reilleya/RMTS-Hardware/RMTS.kicad_pcb

## KiCad design RMTS.kicad_pcb (2025-01-09)

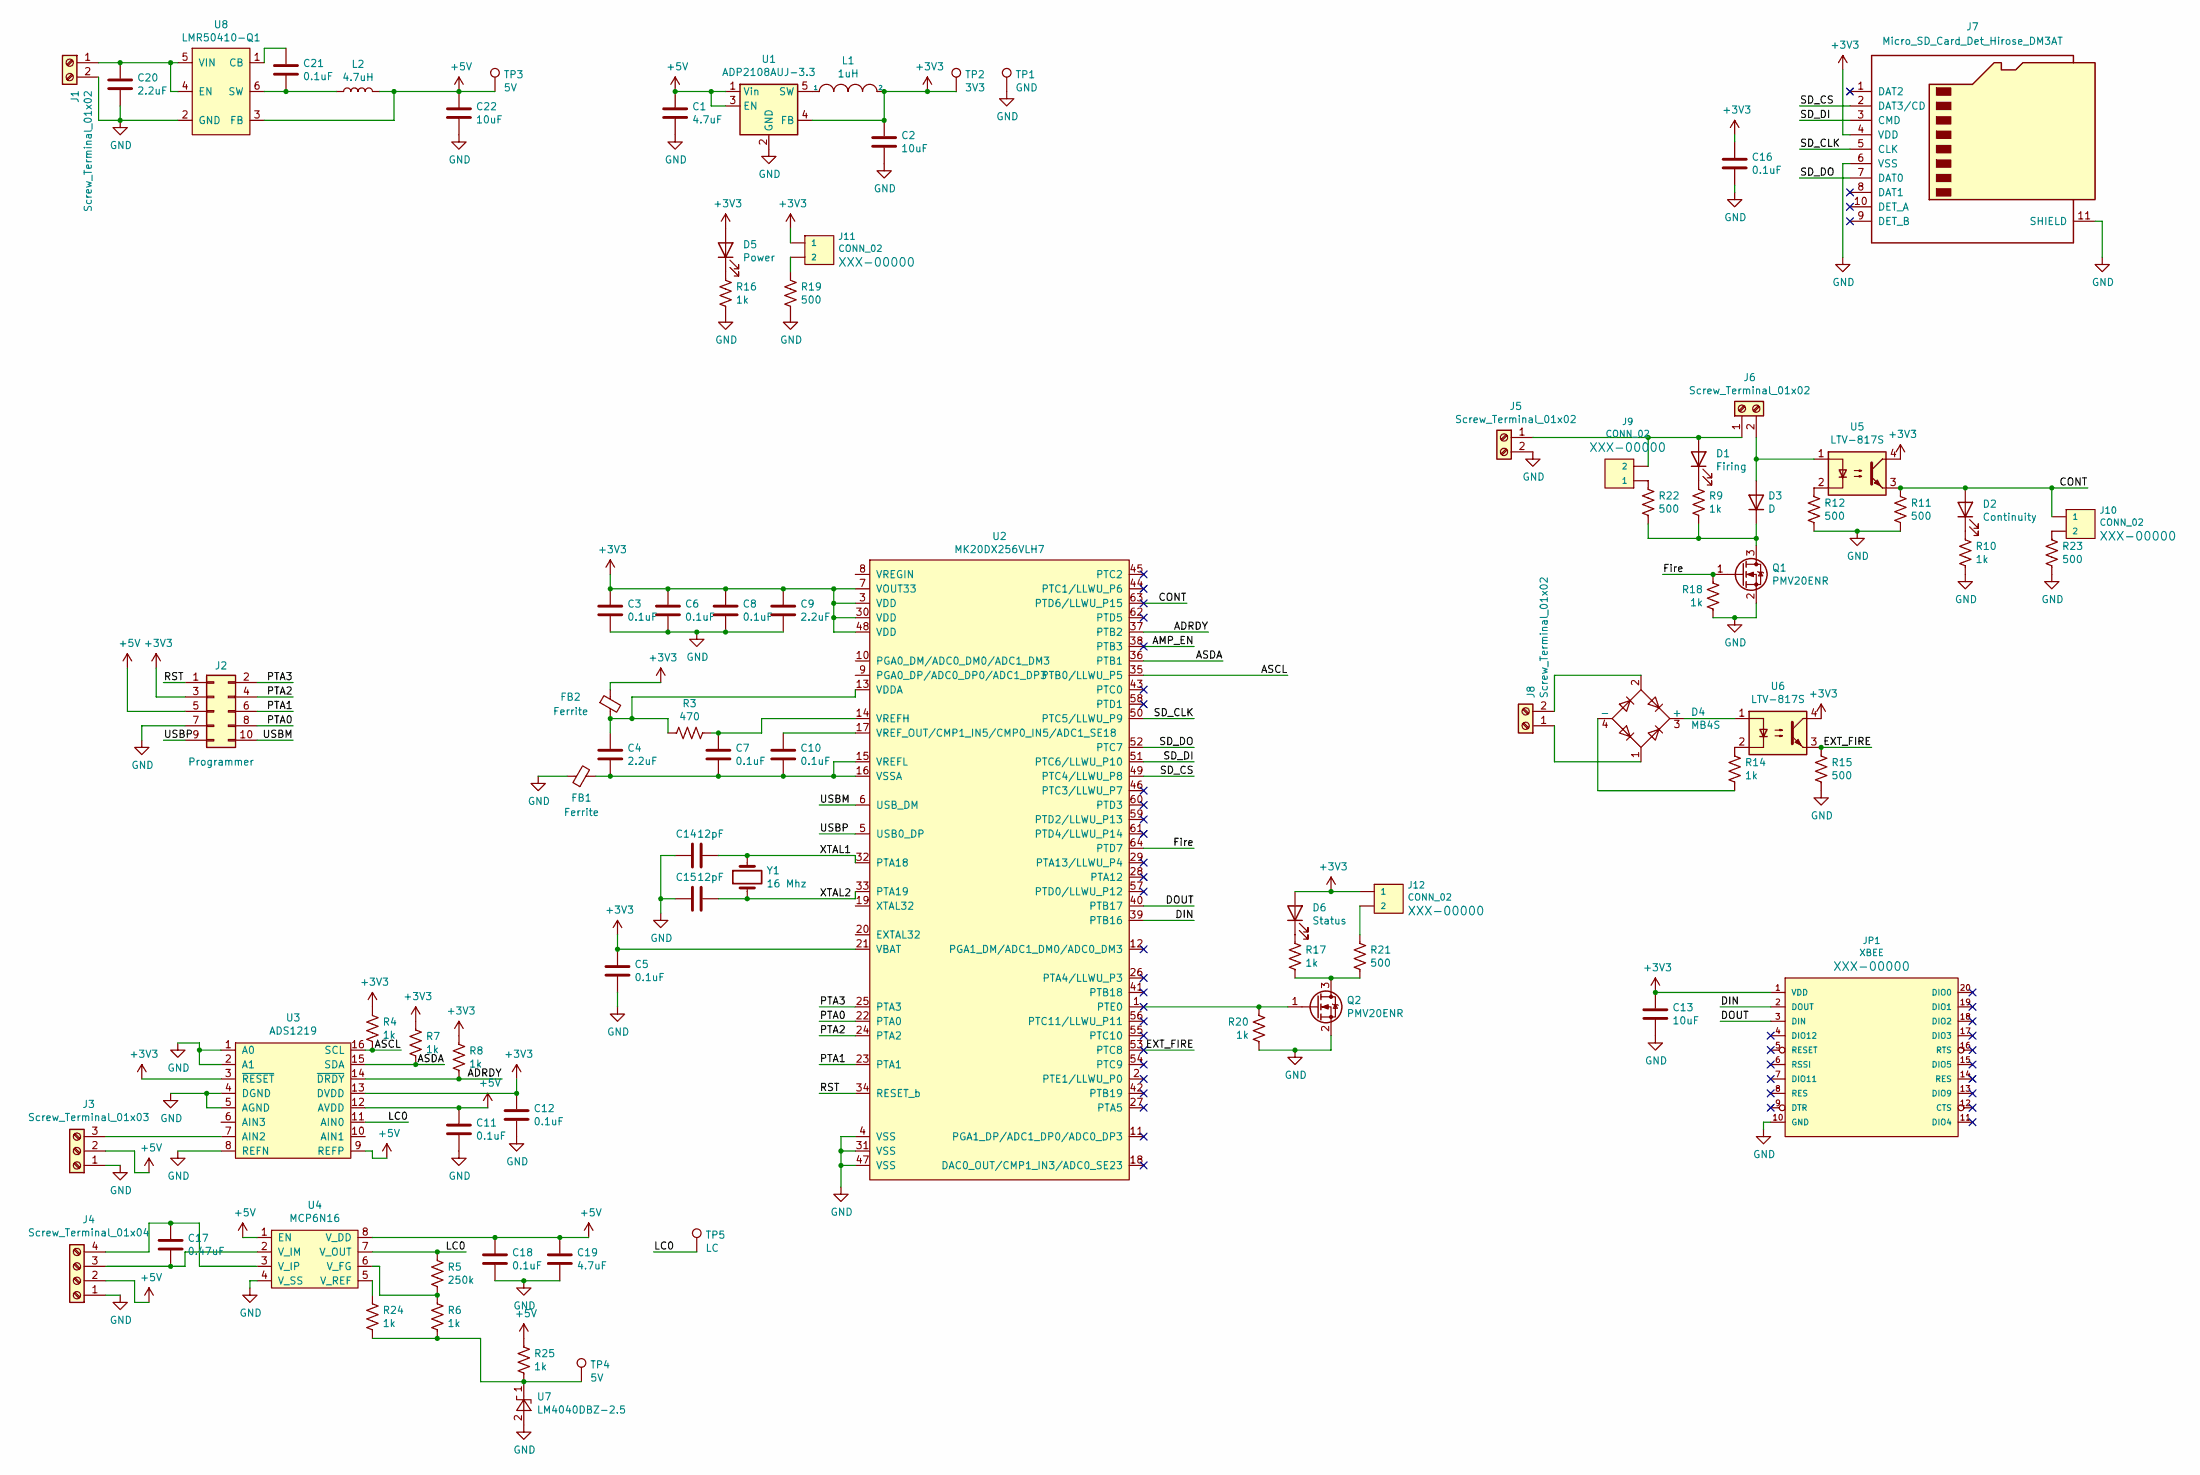
[picture p1: schematic RMTS.kicad_sch]

Parts:
C1, C19: 4.7uF; C_0805_2012Metric_Pad1.15x1.40mm_HandSolder; LCSC C1779
C2: 10uF; CP_Elec_5x3.9; LCSC C340737
C3, C5, C6, C7, C8, C10, C11, C12, C16, C18, C21: 0.1uF; C_0805_2012Metric_Pad1.15x1.40mm_HandSolder; LCSC C49678
C4, C9, C20: 2.2uF; C_0805_2012Metric_Pad1.15x1.40mm_HandSolder; LCSC C125847
C13, C22: 10uF; C_0805_2012Metric_Pad1.15x1.40mm_HandSolder; LCSC C15850
C14, C15: 12pF; C_0805_2012Metric_Pad1.15x1.40mm_HandSolder; LCSC C1792
C17: 0.47uF; C_0805_2012Metric_Pad1.15x1.40mm_HandSolder; LCSC C13967
D1: Firing; LED_0805_2012Metric_Pad1.15x1.40mm_HandSolder; LCSC C84256
D2: Continuity; LED_0805_2012Metric_Pad1.15x1.40mm_HandSolder; LCSC C84256
D3: D; D_SOD-128; LCSC C552950
D4: MB4S; TO-269AA; LCSC C151727
D5: Power; LED_0805_2012Metric_Pad1.15x1.40mm_HandSolder; LCSC C84256
D6: Status; LED_0805_2012Metric_Pad1.15x1.40mm_HandSolder; LCSC C84256
FB1, FB2: Ferrite; C_0805_2012Metric_Pad1.15x1.40mm_HandSolder; LCSC C97001
J1, J5, J6, J8: Screw_Terminal_01x02; SCREWTERMINAL-3.5MM-2
J2: Programmer; PinHeader_2x05_P2.00mm_Vertical
J3: Screw_Terminal_01x03; SCREWTERMINAL-3.5MM-3
J4: Screw_Terminal_01x04; SCREWTERMINAL-3.5MM-4
J7: Micro_SD_Card_Det_Hirose_DM3AT; microSD_HC_Hirose_DM3AT-SF-PEJM5
J9, J10, J11, J12: CONN_02; 1X02
JP1: XBEE
L1: 1uH; L_0805_2012Metric_Pad1.15x1.40mm_HandSolder; LCSC C1042
L2: 4.7uH; L_0805_2012Metric_Pad1.15x1.40mm_HandSolder; LCSC C86090
Q1, Q2: PMV20ENR; SOT-23; LCSC C456088
R3: 470; R_0805_2012Metric_Pad1.15x1.40mm_HandSolder; LCSC C17710
R4, R6, R7, R8, R9, R10, R14, R16, R17, R18, R20, R24, R25: 1k; R_0805_2012Metric_Pad1.15x1.40mm_HandSolder; LCSC C17513
R5: 250k; R_0805_2012Metric_Pad1.15x1.40mm_HandSolder; LCSC C25825
R11, R12, R15, R19, R22, R23: 500; R_0805_2012Metric_Pad1.15x1.40mm_HandSolder; LCSC C17734
R21: 500; R_0805_2012Metric_Pad1.15x1.40mm_HandSolder; LCSC C17513
TP1: GND; TestPoint_THTPad_2.0x2.0mm_Drill1.0mm
TP2: 3V3; TestPoint_THTPad_2.0x2.0mm_Drill1.0mm
TP3, TP4: 5V; TestPoint_THTPad_2.0x2.0mm_Drill1.0mm
TP5: LC; TestPoint_THTPad_2.0x2.0mm_Drill1.0mm
U1: ADP2108AUJ-3.3; TSOT-23-5; LCSC C143875
U2: MK20DX256VLH7; LQFP-64_10x10mm_P0.5mm; LCSC C511780
U3: ADS1219; TSSOP-16_4.4x5mm_P0.65mm; LCSC C2869313
U4: MCP6N16; MSOP-8_3x3mm_P0.65mm; LCSC C636381
U5, U6: LTV-817S; SMDIP-4_W9.53mm; LCSC C189217
U7: LM4040DBZ-2.5; SOT-23; LCSC C468180
U8: LMR50410-Q1; SOT-23-6; LCSC C2871822
Y1: 16 Mhz; HC-49S-SMD-2P-Mini; LCSC C2975359

Connections:
+3V3: C2.1, C3.1, C5.1, C6.1, C8.1, C9.1, C12.1, C13.1, C16.1, D5.2 (A), D6.2 (A), FB2.1, J2.3, J7.4 (VDD), J11.1, J12.1, JP1.1 (VDD), L1.2, R4.1, R7.1, R8.1, TP2.1, U1.4 (FB), U2.3 (VDD), U2.7 (VOUT33), U2.21 (VBAT), U2.30 (VDD), U2.48 (VDD), U3.3 (~RESET), U3.13 (DVDD), U5.4, U6.4
+5V: C1.1, C11.1, C18.1, C19.1, C22.1, J2.5, J3.2, J4.2, L2.2, R25.1, TP3.1, U1.1 (Vin), U1.3 (EN), U3.9 (REFP), U3.12 (AVDD), U4.1 (EN), U4.8 (V_DD), U8.3 (FB)
/ADRDY: R8.2, U2.37 (PTB2), U3.14 (~DRDY)
/AMP_EN: U2.38 (PTB3)
/ASCL: R4.2, U2.35 (PTB0/LLWU_P5), U3.16 (SCL)
/ASDA: R7.2, U2.36 (PTB1), U3.15 (SDA)
/CONT: D2.2 (A), J10.1, R11.1, U2.63 (PTD6/LLWU_P15), U5.3
/DIN: JP1.2 (DOUT), U2.39 (PTB16)
/DOUT: JP1.3 (DIN), U2.40 (PTB17)
/EXT_FIRE: R15.1, U2.53 (PTC8), U6.3
/Fire: Q1.1 (G), R18.1, U2.64 (PTD7)
/LC0: R5.1, TP5.1, U3.11 (AIN0), U4.7 (V_OUT)
/PTA0: J2.8, U2.22 (PTA0)
/PTA1: J2.6, U2.23 (PTA1)
/PTA2: J2.4, U2.24 (PTA2)
/PTA3: J2.2, U2.25 (PTA3)
/RST: J2.1, U2.34 (RESET_b)
/SD_CLK: J7.5 (CLK), U2.50 (PTC5/LLWU_P9)
/SD_CS: J7.2 (DAT3/CD), U2.49 (PTC4/LLWU_P8)
/SD_DI: J7.3 (CMD), U2.51 (PTC6/LLWU_P10)
/SD_DO: J7.7 (DAT0), U2.52 (PTC7)
/USBM: J2.10, U2.6 (USB_DM)
/USBP: J2.9, U2.5 (USB0_DP)
/XTAL1: C14.1, U2.32 (PTA18), Y1.1
/XTAL2: C15.1, U2.33 (PTA19), Y1.2
GND: C1.2, C2.2, C3.2, C5.2, C6.2, C8.2, C9.2, C11.2, C12.2, C13.2, C14.2, C15.2, C16.2, C18.2, C19.2, C20.2, C22.2, FB1.1, J1.2, J2.7, J3.1, J4.1, J5.2, J7.6 (VSS), J7.11 (SHIELD), JP1.10 (GND), Q1.2 (S), Q2.2 (S), R10.2, R11.2, R12.2, R15.2, R16.2, R18.2, R19.2, R20.2, R23.2, TP1.1, U1.2 (GND), U2.4 (VSS), U2.31 (VSS), U2.47 (VSS), U3.1 (A0), U3.2 (A1), U3.4 (DGND), U3.5 (AGND), U3.8 (REFN), U4.4 (V_SS), U7.2 (A), U8.2 (GND)
unnamed: D1.2 (A), J5.1, J6.1, J9.2
unnamed: D1.1 (K), R9.1
unnamed: D2.1 (K), R10.1
unnamed: D3.2 (A), J6.2, U5.1
unnamed: D3.1 (K), Q1.3 (D), R9.2, R22.2
unnamed: D4.3 (+), U6.1
unnamed: D4.4 (-), R14.2
unnamed: D5.1 (K), R16.1
unnamed: D6.1 (K), R17.1
unnamed: C20.1, J1.1, U8.4 (EN), U8.5 (VIN)
unnamed: J3.3, U3.7 (AIN2)
unnamed: C17.2, J4.3, U4.2 (V_IM)
unnamed: C17.1, J4.4, U4.3 (V_IP)
unnamed: D4.1, J8.1
unnamed: D4.2, J8.2
unnamed: J9.1, R22.1
unnamed: J10.2, R23.1
unnamed: J11.2, R19.1
unnamed: J12.2, R21.1
unnamed: Q2.3 (D), R17.2, R21.2
unnamed: R12.1, U5.2
unnamed: R14.1, U6.2
unnamed: L1.1, U1.5 (SW)
unnamed: C4.1, FB2.2, R3.2, U2.13 (VDDA)
unnamed: C7.1, R3.1, U2.14 (VREFH)
unnamed: C4.2, C7.2, C10.2, FB1.2, U2.15 (VREFL), U2.16 (VSSA)
unnamed: C10.1, U2.17 (VREF_OUT/CMP1_IN5/CMP0_IN5/ADC1_SE18)
unnamed: R5.2, R6.1, U4.6 (V_FG)
unnamed: R24.1, U4.5 (V_REF)
unnamed: R6.2, R24.2, R25.2, TP4.1, U7.1 (K)
unnamed: C21.1, U8.1 (CB)
unnamed: C21.2, L2.1, U8.6 (SW)

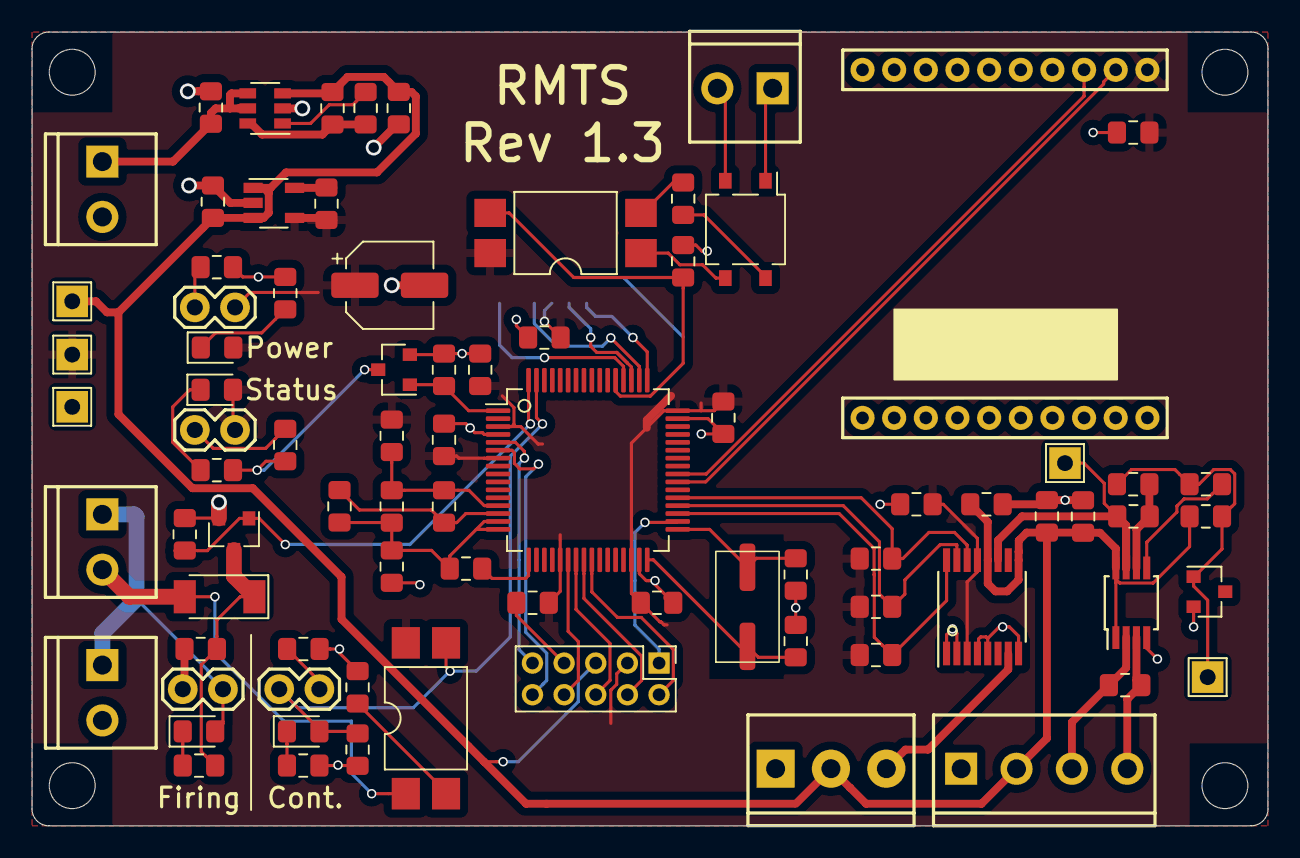
[picture p2: board RMTS.kicad_pcb from above]

Board: 2 copper layers, 78.1 x 50.2 mm, 83 parts (1 on the bottom side), 57 nets.
