reilleya/RMTS-Hardware/(threads)

Thread 2 (2019-12-23):

Test stand data

benrussell11, 2019-12-23:
Hi Andrew,

I was wondering if you can send me a couple of sets of data from your test stand?

My in-flight data logger is working and I'd like to be able to compare your test results with thrust derived from pressure using my spreadsheet.

Best format would be a csv file: Time (sec), pressure (psi), thrust (lbs) and the exit and throat diameters (in) or what whatever units the data were recorded in.

I'll share the results.

Ben

Closed 2020-03-19.

Thread 3 (2020-01-30):

Add resistor to make more batteries recognize board

reilleya, 2020-01-30:
Due to the board's low current draw, some batteries seem to not notice that it is connected and do not give it current. Others will power it but only when transducers are connected. To fix this, add a resistor (maybe 700 ohms like the load cell) between 5v and ground to keep batteries from powering off.

Closed 2020-03-12.

Thread 4 (2020-08-26):

Fix external LED headers

reilleya, 2020-08-26:
The external LED headers have low forward voltage so they don't work with anything other than red LEDs. Change it so they aren't directly in parallel with the onboard LEDs and give them a higher voltage.

Closed 2020-12-15.

Thread 6 (2020-12-22):

Remove USB port

reilleya, 2020-12-22:
Replace it with terminal blocks and a 5V regulator

Closed 2021-01-24.
