reilleya/RMTS-Hardware/(commit log)

2019-07-29 Initial commit with schematic
    [RMTS.kicad_pcb, RMTS.sch]
2019-08-02 Updated schematic, started layout
    [RMTS.kicad_pcb, RMTS.sch]
2019-08-03 Added load capacitors to crystal
    [RMTS.sch]
2019-08-03 Fixed unit notation
    [RMTS.sch]
2019-08-03 Added backup crystal schematic symbol
    [RMTS.sch]
2019-08-03 Updated SD card connector to standard
    [RMTS.sch]
2019-08-03 Removed previous SD card connector
    [RMTS.sch]
2019-08-03 Added no-connect flags
    [RMTS.sch]
2019-08-03 Fixed rescued symbols
    [RMTS.sch]
2019-08-03 Fixed broken header
    [RMTS.sch]
2019-08-03 Fixed older microSD footprint
    [RMTS.sch]
2019-08-10 Finished layout
    [RMTS.kicad_pcb, RMTS.sch]
2019-08-11 Cleaned up silkscreen
    [RMTS.kicad_pcb]
2019-08-11 Added label to screw terminals
    [RMTS.kicad_pcb]
2019-08-11 Added 3v3 top plane
    [RMTS.kicad_pcb]
2019-08-24 Changed USB to full size, connected amp enable, cleaned up routing
    [RMTS.kicad_pcb, RMTS.sch]
2019-08-25 Fixed mistakes
    [RMTS.kicad_pcb, RMTS.sch]
2019-08-25 Added keepout regions near mounting holes
    [RMTS.kicad_pcb]
2019-09-08 Pulled ADC enable high, added diode to firing circuit, rerouted some traces
    [RMTS.kicad_pcb, RMTS.sch]
2019-09-15 Removed backup crystal, resized board
    [RMTS.kicad_pcb, RMTS.sch]
2019-10-07 Added continuity optocoupler, capacitor pads to loadcell connection
    [RMTS.kicad_pcb, RMTS.sch]
2020-02-08 Added resistor to avoid battery shutting off
    [RMTS.kicad_pcb, RMTS.sch]
2020-02-12 Removed USB pyro power jumper
    [RMTS.kicad_pcb, RMTS.sch]
2020-02-25 Updated amplifier to MCP6N16, incremented revision number
    [RMTS.kicad_pcb, RMTS.sch]
2020-03-05 Flipped SD card, added external firing circuit
    [RMTS.kicad_pcb, RMTS.sch]
2020-03-06 Added power LED, moved labels, cleaned up some traces
    [RMTS.kicad_pcb, RMTS.sch]
2020-03-10 Added status LED, hid labels
    [RMTS.kicad_pcb, RMTS.sch]
2020-03-12 Added headers for LEDs, aligned some components better
    [RMTS.kicad_pcb, RMTS.sch]
2020-03-28 Added logo
    [RMTS.kicad_pcb]
2020-03-29 Added silkscreen box for serial number
    [RMTS.kicad_pcb]
2020-04-12 Increased font size of terminal block labels
    [RMTS.kicad_pcb]
2020-04-20 Updated logo to bitmap
    [RMTS.kicad_pcb]
2020-05-23 Add pulldown to firing circuit
    [RMTS.kicad_pcb, RMTS.sch]
2020-06-29 Add LCSC part numbers to components
    [RMTS.kicad_pcb, RMTS.sch]
2020-09-17 Made external LED channels separate from onboard LEDs
    [RMTS.kicad_pcb, RMTS.sch]
2020-09-22 Decrease keepalive resistor value
    [RMTS.kicad_pcb, RMTS.sch]
2020-09-29 Increase resistance of trigger circuit
    [RMTS.kicad_pcb, RMTS.sch]
2020-12-27 Improve amplifier circuit
    [RMTS.kicad_pcb, RMTS.sch]
2021-01-17 Update programmer header, remove USB port
    [RMTS.kicad_pcb, RMTS.sch]
2021-01-18 Added 5v reg, broke layout
    [RMTS.kicad_pcb, RMTS.sch]
2021-01-21 Fixed layout of new 5v regulator
    [RMTS.kicad_pcb]
2021-01-24 Upgrade firing diode
    [RMTS.kicad_pcb, RMTS.sch]
2021-01-24 Added test points
    [RMTS.kicad_pcb, RMTS.sch]
2021-01-30 Adjust silkscreen
    [RMTS.kicad_pcb]
2021-01-30 Get 5v from programmer
    [RMTS.kicad_pcb, RMTS.sch]
2021-02-20 Fix 5v regulator
    [RMTS.kicad_pcb, RMTS.sch]
2021-02-23 Fix status LED
    [RMTS.kicad_pcb, RMTS.sch]
2021-03-13 Swap out diode footprint
    [RMTS.kicad_pcb, RMTS.sch]
2021-03-22 Update LCSC
    [RMTS.kicad_pcb, RMTS.sch]
2024-07-10 Update to KiCad 8
    [RMTS.kicad_pcb, RMTS.kicad_sch]
2025-01-09 Have JLC populate more components
    [RMTS.kicad_pcb, RMTS.kicad_sch]
